SmartDev527/xIMU/MiniIMU-V6/MiniIMU-V6/Proto_photo/5369 1.jpg

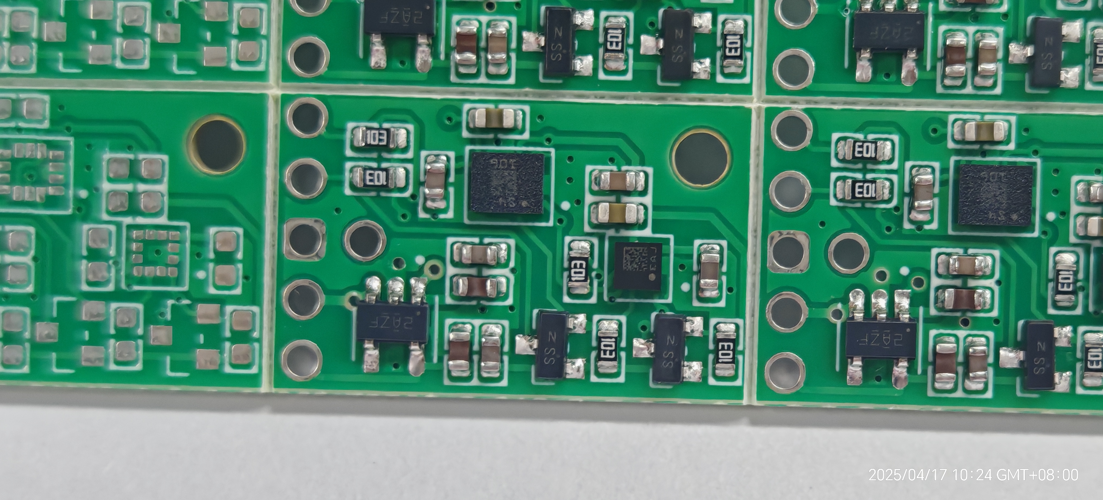
MiniIMU-V6/MiniIMU-V6/Proto_photo/5369 1.jpg
