SmartDev527/xIMU/MiniIMU-V6/MiniIMU-V6/Manufacturing_Files/요소명세표.xls

PCBWay Bom Quotation, Product No.:T-I72W285672A
Item # | *Designator | *Qty | Manufacturer | *Mfg Part # | Description / Value | *Package/Footprint | *Unit Price(10 sets) | *Total | *Delivery Time | Customer Reply | PCBWay Update
1 | C4, C5, C6, C8, C9 | 5 | Yageo | CC0603KRX7R7BB104 | 0.1uF『 』CAP, MLCC, 0.1uF, 16V, 0603, 5% |  | $0.006 | $0.300
2 | C3, C7 | 2 | Yageo | CC0603KRX7R7BB105 | 1uF『 』CAP, MLCC, 1uF, 16V, 0603, 5%, X7R |  | $0.050 | $1.000
3 | C1, C2 | 2 | Yageo | CC0603KRX5R7BB475 | 4.7uF『 』CAP, MLCC, 4.7uF, 16V, 0603, 5%, X7R |  | $0.050 | $1.000
4 | U1 | 1 | Texas Instruments | TPS7A2033PDBVR | TPS7A2033PDBVR『 』IC REG LINEAR 3.3V 300MA SOT23-5 |  | $0.296 | $2.960 | 7-10 Workdays
5 | U2 | 1 | STMicroelectronics | LSM6DSOXTR | LSM6DSOXTR『 』INEMO INERTIAL MODULE: 3D ACCELE |  | $4.694 | $46.940 | 7-10 Workdays
6 | Q1, Q2 | 2 | ON Semiconductor / Fairchild | BSS138 | BSS138『 』MOSFET N-CH 50V 220MA SOT-23 |  | $0.256 | $5.120 | 7-10 Workdays
7 | R1, R2, R3, R4, R5 | 5 | Yageo | AC0603JR-0710KL | 10K『 』RESISTOR, SMD, 10K, 0603, 5% |  | $0.015 | $0.750
8 | U3 | 1 | STMicroelectronics | LIS3MDLTR | LIS3MDLTR『 』SENSOR MR I2C/SPI 12LGA |  | $4.234 | $42.340 | 7-10 Workdays
 |  |  |  |  |  |  | Component Cost | $100.41
 |  |  |  |  |  |  | Assembly Cost | $29.00
 |  |  |  |  |  |  | PCB Cost | $5.00
 |  |  |  |  |  |  | V3 Member 3% off | -$1.02
 |  |  |  |  |  |  | All Total 10 Sets | $133.39
