SmartDev527/xIMU/(list of files, drawings)

Other design files:
MiniIMU-V6/MiniIMU-V6/Altium_xIMU/xIMU_V527/x_con.PcbLib
MiniIMU-V6/MiniIMU-V6/Altium_xIMU/xIMU_V527/xIMU_527.PcbDoc
MiniIMU-V6/MiniIMU-V6/Altium_xIMU/xIMU_V527/xIMU_V527.PrjPcb
MiniIMU-V6/MiniIMU-V6/Altium_xIMU/xIMU_V527/xIMU_V527.SchDoc
