SmartDev527/xIMU/MiniIMU-V6/MiniIMU-V6/Test_Doc/xIMU_V527 测试流程 (中文).docx

# xIMU_V527 测试流程 (中文)

## 简介

本文档提供了一种详细的、逐步的测试方法，用于测试 xIMU_V527 模块，该模块包含3轴加速度计、3轴陀螺仪（LSM6DSO）和3轴磁力计（LIS3MDL）。测试使用 Arduino Uno 通过I²C接口读取传感器数据，并在Arduino串口监视器上显示。此流程确保模块的传感器正常运行，适用于PCB制造环境中的质量控制。

## 所需材料

- xIMU_V527 模块（待测设备）
- Arduino Uno（或支持I²C的兼容微控制器）
- 跳线（公对公或公对母，至少4根）
- 面包板（可选，用于稳定连接）
- USB A到B电缆（用于将Arduino Uno连接到计算机）
- 计算机，已安装Arduino IDE（Windows、macOS或Linux）
- 稳定电源（通过USB或Arduino的5V引脚提供）

## 安全注意事项

- 确保在Arduino断电状态下进行所有连接，以避免短路。
- 确认xIMU_V527不暴露在静电环境中，因为其包含敏感元件。尽可能使用接地工作站。
- 不要向xIMU_V527的VIN引脚施加高于5.5V的电压，以防损坏。
- 小心操作模块，避免弯曲引脚或损坏焊点。

## 逐步测试流程

### 步骤 1：设置硬件

1. 关闭Arduino Uno电源，确保连接安全。
2. 使用跳线将 xIMU_V527 连接到 Arduino Uno，连接如下：
  - VIN（xIMU_V527）到 5V（Arduino Uno）：为模块供电。
  - GND（xIMU_V527）到 GND（Arduino Uno）：建立公共接地。
  - SDA（xIMU_V527）到 A4（Arduino Uno）：I²C数据线。
  - SCL（xIMU_V527）到 A5（Arduino Uno）：I²C时钟线。
3. 可选：使用面包板固定连接，减少松动风险。
4. 根据xIMU_V527板上的引脚标签仔细检查连接，避免错误。
5. 确保没有其他设备连接到Arduino，以防止I²C总线冲突。

### 步骤 2：安装Arduino IDE

1. 如果尚未安装，从 (https://www.arduino.cc/en/software)arduino.cc (https://www.arduino.cc/en/software) 下载并安装 Arduino IDE。
2. 使用 USB A到B电缆 将 Arduino Uno 连接到计算机。
3. 验证计算机是否识别Arduino（在Windows上检查设备管理器，在macOS/Linux上检查系统信息，寻找COM端口）。

### 步骤 3：安装所需库

1. 打开 Arduino IDE。
2. 导航到 草图 > 包含库 > 管理库。
3. 搜索并安装以下Pololu库：
  - LSM6：用于LSM6DSO（陀螺仪和加速度计）。
  - LIS3MDL：用于LIS3MDL（磁力计）。
4. 或者，从Pololu的GitHub下载库：
  - LSM6库 (https://github.com/pololu/lsm6-arduino)
  - LIS3MDL库 (https://github.com/pololu/lis3mdl-arduino)
  - 通过 草图 > 包含库 > 添加.ZIP库 安装。
5. 确认库已安装，在 草图 > 包含库 中检查是否有LSM6和LIS3MDL条目。

### 步骤 4：上传测试代码

将以下测试代码复制并粘贴到Arduino IDE的新窗口中：

#include <Wire.h>

#include <LSM6.h>

#include <LIS3MDL.h>

LSM6 imu;

LIS3MDL mag;

void setup() {

Serial.begin(9600);

Wire.begin();

// 初始化LSM6DSO（陀螺仪和加速度计）

if (!imu.init()) {

Serial.println("初始化LSM6DSO失败！");

while (1);

}

imu.enableDefault();

// 初始化

// 初始化LIS3MDL（磁力计）

if (!mag.init()) {

Serial.println("初始化LIS3MDL失败！");

while (1);

}

mag.enableDefault();

}

void loop() {

// 读取加速度计和陀螺仪数据

imu.read();

Serial.print("加速度 (g): ");

Serial.print(imu.a.x * 0.000061); // 转换为g（±2g范围）

Serial.print(", ");

Serial.print(imu.a.y * 0.000061);

Serial.print(", ");

Serial.print(imu.a.z * 0.000061);

Serial.print(" | 陀螺仪 (dps): ");

Serial.print(imu.g.x * 0.00875); // 转换为dps（±250dps范围）

Serial.print(", ");

Serial.print(imu.g.y * 0.00875);

Serial.print(", ");

Serial.print(imu.g.z * 0.00875);

// 读取磁力计数据

mag.read();

Serial.print(" | 磁场 (gauss): ");

Serial.print(mag.m.x * 0.00014); // 转换为gauss（±4 gauss范围）

Serial.print(", ");

Serial.print(mag.m.y * 0.00014);

Serial.print(", ");

Serial.print(mag.m.z * 0.00014);

Serial.println();

delay(500); // 每500毫秒更新一次

}

1. 代码说明：
  - 初始化I²C通信和串口监视器。
  - 检查LSM6DSO和LIS3MDL是否正确初始化。
  - 从加速度计、陀螺仪和磁力计读取原始数据。
  - 使用默认缩放因子将原始值转换为物理单位（g、每秒度、高斯）。
  - 每500毫秒将数据输出到串口监视器。

### 步骤 5：上传并运行测试

1. 在Arduino IDE中，选择 工具 > 开发板 > Arduino Uno。
2. 在 工具 > 端口 下选择正确的端口（例如，Windows上的COM3或Linux上的/dev/ttyACM0）。
3. 点击 上传，编译并将代码上传到Arduino Uno。
4. 打开 串口监视器（工具 > 串口监视器），将波特率设置为 9600。
5. 观察输出，格式应如下： 加速度 (g): 0.01, -0.02, 0.98 | 陀螺仪 (dps): 0.1, -0.2, 0.0 | 磁场 (gauss): 0.15, -0.10, 0.30

### 步骤 6：验证传感器功能

1. 加速度计测试：
  - 将模块平放（Z轴朝上）。Z轴应读取大约1g（由于重力）。
  - 沿X轴和Y轴倾斜模块。数值应平滑变化（例如，向右倾斜时X值增加）。
2. 陀螺仪测试：
  - 绕每个轴（X、Y、Z）旋转模块。旋转时数值应出现峰值，静止时接近零。
3. 磁力计测试：
  - 在不同方向移动模块或靠近弱磁铁。数值应根据方向或磁场变化。
  - 注意：室内磁力计读数可能因干扰而变化。
4. 如果所有传感器显示出响应合理的数值，则模块功能正常。

### 步骤 7：记录结果

1. 记录至少10秒的串口监视器输出，以确认数据一致性。
2. 记录任何异常情况（例如，数值不变、初始化错误）。
3. 如果模块通过所有测试，标记为 合格。如果未通过，继续进行故障排除。

## 故障排除

- 无串口输出：
  - 确认串口监视器波特率设置为9600。
  - 检查USB电缆和端口选择。
  - 确保Arduino Uno已通电（LED亮起）。
- 初始化错误（例如，“初始化LSM6DSO失败！”）：
  - 仔细检查接线（VIN到5V，GND到GND，SDA到A4，SCL到A5）。
  - 检查xIMU_V527上的焊点是否有缺陷。
  - 使用另一个xIMU_V527测试，以隔离模块或设置问题。
- 数值不稳定：
  - 固定所有连接，消除松动导线。
  - 将模块远离金属物体或磁干扰。
  - 验证Arduino的5V引脚提供稳定电压（必要时使用万用表）。
- 库问题：
  - 重新安装LSM6和LIS3MDL库。
  - 确保未安装冲突的库（例如，通用的LSM6DSO库）。

## 通过/失败标准

- 通过：所有三个传感器（加速度计、陀螺仪、磁力计）在串口监视器中产生响应且合理的数值，随运动适当地变化。
- 失败：任何传感器无法初始化、无数据输出或在故障排除后输出不响应/不稳定数值。

## 附加说明

- 此测试确认基本功能。对于高级应用（例如，AHRS），可能需要进一步校准或测试。
- 参考 (https://www.st.com/resource/en/datasheet/lsm6dso.pdf)LSM6DSO数据手册 (https://www.st.com/resource/en/datasheet/lsm6dso.pdf) 和 (https://www.st.com/resource/en/datasheet/lis3mdl.pdf)LIS3MDL数据手册 (https://www.st.com/resource/en/datasheet/lis3mdl.pdf) 获取详细传感器规格。
- 如果测试多个模块，确保逐个测试以避免I²C地址冲突。
