SmartDev527/xIMU/(commit log)

2025-05-19 Send company
    [xIMU_527.PcbDoc, xIMU_V527.PrjPcb, xIMU_V527.SchDoc, x_con.PcbLib, 요소명세표.xls]
2025-05-19 STMems Drivers upload
